menkueclab/BIPOLAR-FHDO/README.md

# BIPOLAR-FHDO
Add-on board with bipolar voltage output for the GPA-FHDO
