menkueclab/BIPOLAR-FHDO/(commit log)

2022-01-14 added interface
    [BIPOLAR-FHDO.kicad_pcb, BIPOLAR-FHDO.kicad_sch]
2022-01-14 added opamp circuit for 1 channel
    [BIPOLAR-FHDO.kicad_pcb, BIPOLAR-FHDO.kicad_sch]
2022-01-14 completed schematic
    [BIPOLAR-FHDO.kicad_pcb, BIPOLAR-FHDO.kicad_sch]
2022-02-04 completed layout
    [BIPOLAR-FHDO.kicad_pcb, BIPOLAR-FHDO.kicad_sch]
2022-02-04 some fixes
    [BIPOLAR-FHDO.kicad_pcb, BIPOLAR-FHDO.kicad_sch]
2022-02-04 small fixes
    [BIPOLAR-FHDO.kicad_pcb]
2022-02-04 small fix
    [BIPOLAR-FHDO.kicad_pcb]
2022-02-04 add more labels
    [BIPOLAR-FHDO.kicad_pcb]
2022-02-04 added some notes
    [BIPOLAR-FHDO.kicad_sch]
2022-02-05 added SMA connector for DAC outs
    [BIPOLAR-FHDO.kicad_pcb, BIPOLAR-FHDO.kicad_sch]
2022-02-08 optimized layout
    [BIPOLAR-FHDO.kicad_pcb]
2022-02-08 rename outputs
    [BIPOLAR-FHDO.kicad_pcb]
2022-02-09 put buffer OPAMP on +-Vs
    [BIPOLAR-FHDO.kicad_pcb, BIPOLAR-FHDO.kicad_sch]
2022-02-09 update schematic
    [BIPOLAR-FHDO.kicad_sch]
2022-03-03 version 1.1 (work in progress)
    added jumper vor ext voltage
    edited silkscreen
    [BIPOLAR-FHDO.kicad_pcb, BIPOLAR-FHDO.kicad_sch]
2022-03-07 updated symbol libraries / fixed ERC errors
    [BIPOLAR-FHDO.kicad_pcb, BIPOLAR-FHDO.kicad_sch]
